bullestock/acsv2/mqtt-logger/README.md

This script subscribes to hal9k/acs/log/# and writes all received data to a log file.
The file is rotated hourly, and up to 30 files are kept.
