bullestock/acsv2/frontend/design/states.png

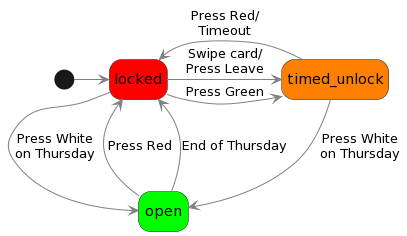
frontend/design/states.png
