bullestock/acsv2/frontend/case/bottom.step

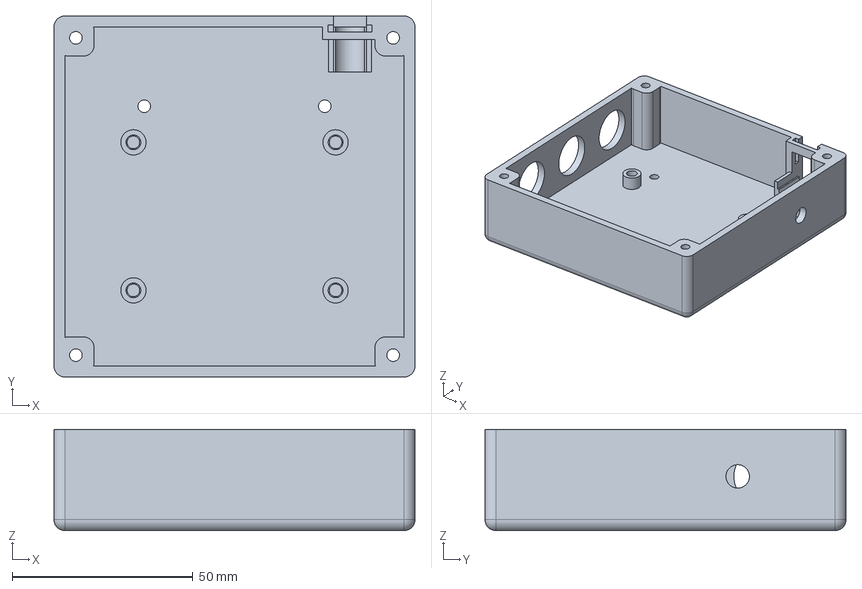
[picture p4: CAD file, 2026-07-11]
frontend/case/bottom.step
100.0 x 100.0 x 28.0 mm
