bullestock/acsv2/frontend/opi/installed-packages.txt

emacs-bin-common
emacs-common
emacs-nox
emacsen-common
libboost-iostreams1.74.0:armhf
libboost-program-options-dev:armhf
libboost-program-options1.74-dev:armhf
libboost-program-options1.74.0:armhf
libboost-regex1.74.0:armhf
libboost1.74-dev:armhf
libbpf0:armhf
libbrotli-dev:armhf
libbrotli1:armhf
libbsd0:armhf
libbz2-1.0:armhf
libc-bin
libc-dev-bin
libc6:armhf
libc6-dev:armhf
libcaca0:armhf
libcairo-gobject2:armhf
libcairo2:armhf
libcap-ng0:armhf
libcap2:armhf
libcap2-bin
libcc1-0:armhf
libcolord2:armhf
libcom-err2:armhf
libcpufreq0
libcrack2:armhf
libcrypt-dev:armhf
libcrypt1:armhf
libcryptsetup12:armhf
libctf-nobfd0:armhf
libctf0:armhf
libcups2:armhf
libcurl3-gnutls:armhf
libcurl4:armhf
libcurl4-openssl-dev:armhf
libcwidget4:armhf
libdaemon0:armhf
libdatrie1:armhf
libdb5.3:armhf
libdbus-1-3:armhf
libdconf1:armhf
libdebconfclient0:armhf
libdebuginfod1:armhf
libdeflate0:armhf
libdevmapper1.02.1:armhf
libdns-export1110
libdw1:armhf
libedit2:armhf
libelf1:armhf
libepoxy0:armhf
libestr0:armhf
libevent-2.1-7:armhf
libexpat1:armhf
libext2fs2:armhf
libfastjson4:armhf
libfdisk1:armhf
libfdt1:armhf
libffi-dev:armhf
libffi7:armhf
libfftw3-single3:armhf
libfido2-1:armhf
libfontconfig1:armhf
libfreetype6:armhf
libfribidi0:armhf
libfstrm0:armhf
libfuse2:armhf
libgcc-10-dev:armhf
libgcc-s1:armhf
libgcrypt20:armhf
libgcrypt20-dev
libgdbm-compat4:armhf
libgdbm6:armhf
libgdk-pixbuf-2.0-0:armhf
libgdk-pixbuf2.0-common
libgirepository-1.0-1:armhf
libglib2.0-0:armhf
libgmp-dev:armhf
libgmp10:armhf
libgmpxx4ldbl:armhf
libgnutls-dane0:armhf
libgnutls-openssl27:armhf
libgnutls28-dev:armhf
libgnutls30:armhf
libgnutlsxx28:armhf
libgomp1:armhf
libgpg-error-dev
libgpg-error0:armhf
libgpiod-dev:armhf
libgpiod2:armhf
libgpm2:armhf
libgraphite2-3:armhf
libgss-dev
libgss3:armhf
libgssapi-krb5-2:armhf
libgssrpc4:armhf
libgtk-3-0:armhf
libgtk-3-common
libgudev-1.0-0:armhf
libharfbuzz0b:armhf
libhavege2:armhf
libhogweed6:armhf
libi2c0:armhf
libidn2-0:armhf
libidn2-dev:armhf
libip4tc2:armhf
libip6tc2:armhf
libiperf0:armhf
libisc-export1105:armhf
libisl23:armhf
libiw30:armhf
libjansson4:armhf
libjbig0:armhf
libjq1:armhf
libjson-c5:armhf
libjson-glib-1.0-0:armhf
libjson-glib-1.0-common
libk5crypto3:armhf
libkadm5clnt-mit12:armhf
libkadm5srv-mit12:armhf
libkdb5-10:armhf
libkeyutils-dev:armhf
libkeyutils1:armhf
libklibc:armhf
libkmod2:armhf
libkrb5-3:armhf
libkrb5-dev:armhf
libkrb5support0:armhf
libksba8:armhf
liblcms2-2:armhf
liblmdb0:armhf
liblognorm5:armhf
liblz4-1:armhf
liblzma5:armhf
liblzo2-2:armhf
libmagic-mgc
libmagic1:armhf
libmaxminddb0:armhf
libmd0:armhf
libmm-glib0:armhf
libmnl0:armhf
libmount1:armhf
libmpc3:armhf
libmpdec3:armhf
libmpfr6:armhf
libncurses6:armhf
libncursesw6:armhf
libndp0:armhf
libnetfilter-conntrack3:armhf
libnettle8:armhf
libnewt0.52:armhf
libnfnetlink0:armhf
libnftnl11:armhf
libnghttp2-14:armhf
libnghttp2-dev
libnl-3-200:armhf
libnl-3-dev:armhf
libnl-genl-3-200:armhf
libnl-genl-3-dev:armhf
libnl-route-3-200:armhf
libnm0:armhf
libnpth0:armhf
libnsl-dev:armhf
libnsl2:armhf
libnss-myhostname:armhf
libnuma1:armhf
libonig5:armhf
libp11-kit-dev:armhf
libp11-kit0:armhf
libpackagekit-glib2-18:armhf
libpam-modules:armhf
libpam-modules-bin
libpam-runtime
libpam-systemd:armhf
libpam0g:armhf
libpango-1.0-0:armhf
libpangocairo-1.0-0:armhf
libpangoft2-1.0-0:armhf
libparted2:armhf
libpcap0.8:armhf
libpci3:armhf
libpcre2-8-0:armhf
libpcre3:armhf
libpcsclite1:armhf
libpipeline1:armhf
libpixman-1-0:armhf
libpkcs11-helper1:armhf
libpll-dev
libpll0
libpng16-16:armhf
libpolkit-agent-1-0:armhf
libpolkit-gobject-1-0:armhf
libpopt0:armhf
libprocps8:armhf
libprotobuf-c1:armhf
libproxy1v5:armhf
libpsl-dev:armhf
libpsl5:armhf
libqrencode4:armhf
libreadline8:armhf
librest-0.7-0:armhf
librhash0:armhf
librtmp-dev:armhf
librtmp1:armhf
libsamplerate0:armhf
libsasl2-2:armhf
libsasl2-dev
libsasl2-modules-db:armhf
libsctp1:armhf
libseccomp2:armhf
libselinux1:armhf
libsensors-config
libsensors5:armhf
libshishi-dev:armhf
libshishi0:armhf
libsigc++-2.0-0v5:armhf
libsigsegv2:armhf
libslang2:armhf
libslang2-modules:armhf
libsmartcols1:armhf
libsoup-gnome2.4-1:armhf
libsoup2.4-1:armhf
libsource-highlight-common
libsource-highlight4v5
libsqlite3-0:armhf
libss2:armhf
libssh2-1:armhf
libssh2-1-dev:armhf
libssl-dev:armhf
libstdc++-10-dev:armhf
libstdc++6:armhf
libsysfs2:armhf
libsystemd0:armhf
libtasn1-6:armhf
libtasn1-6-dev:armhf
libtcl8.6:armhf
libteamdctl0:armhf
libthai-data
libthai0:armhf
libtiff5:armhf
libtinfo6:armhf
libtirpc-common
libtirpc-dev:armhf
libtirpc3:armhf
libubsan1:armhf
libuchardet0:armhf
libudev1:armhf
libunbound8:armhf
libunistring-dev:armhf
libunistring2:armhf
libunwind8:armhf
libusb-1.0-0:armhf
libutempter0:armhf
libuuid1:armhf
libuv1:armhf
libvte-2.91-0:armhf
libvte-2.91-common
libwayland-client0:armhf
libwayland-cursor0:armhf
libwayland-egl1:armhf
libwrap0:armhf
libwrap0-dev:armhf
libx11-6:armhf
libx11-data
libxapian30:armhf
libxau6:armhf
libxcb-render0:armhf
libxcb-shm0:armhf
libxcb1:armhf
libxcomposite1:armhf
libxcursor1:armhf
libxdamage1:armhf
libxdmcp6:armhf
libxext6:armhf
libxfixes3:armhf
libxi6:armhf
libxinerama1:armhf
libxkbcommon0:armhf
libxml2:armhf
libxmuu1:armhf
libxrandr2:armhf
libxrender1:armhf
libxtables12:armhf
libxxhash0:armhf
libyaml-0-2:armhf
libz3-4:armhf
libz3-dev:armhf
libzstd1:armhf
zlib1g:armhf
zlib1g-dev:armhf
