bullestock/acsv2/reader/esp32/pcb/reader.kicad_pcb

## KiCad design reader/esp32/pcb/reader.kicad_pcb (2024-09-29)

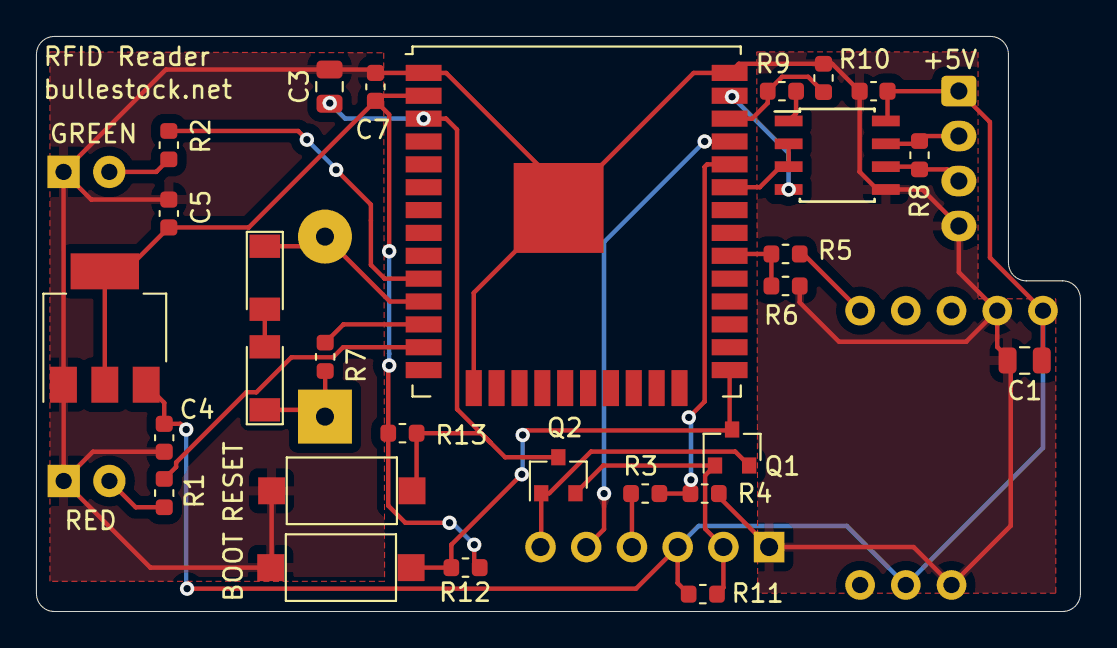
[picture p5: board reader.kicad_pcb from above]

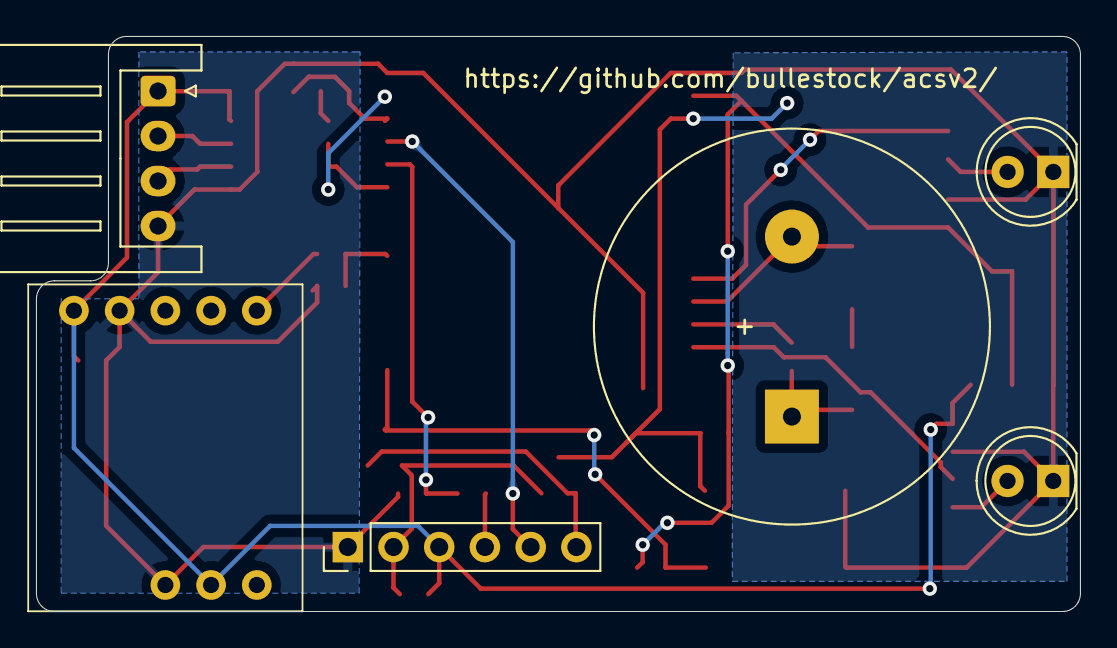
[picture p6: board reader.kicad_pcb from below]

Board: 11 copper layers, 58.0 x 31.9 mm, 34 parts (6 on the bottom side), 26 nets.

Parts:
BZ1: Buzzer; Buzzer_D22mm_H8mm_P10mm
C1, C3: 10u; C_0805_2012Metric
C2, C4, C5, C7: 100n; C_0603_1608Metric
D1, D2: LED; LED_D5.0mm
D3, D4: 3V9; D_MiniMELF
J1: Debug; PinHeader_1x06_P2.54mm_Vertical
J2: RS485; JST_XH_S04B-XH-A_1x04_P2.50mm_Horizontal
Q1, Q2: MMBT3904; SOT-23
R1, R2: 270; R_0603_1608Metric
R3, R5, R9: 1k2; R_0603_1608Metric
R4, R6, R10: 2k2; R_0603_1608Metric
R7: 100; R_0603_1608Metric
R8: 120; R_0603_1608Metric
R11: 4k7; R_0603_1608Metric
R12, R13: 10k; R_0603_1608Metric
SW1, SW2: SW_SPST; SW_SPST_CK_RS282G05A3
U1: ESP32-WROOM-32U
U2: RDM6300; RDM6300_B38.5x18.2mm
U3: MAX485E; SOIC-8_3.9x4.9mm_Pitch1.27mm
U5: AMS1117-3.3; SOT-223-3_TabPin2

Connections:
+3V3: C5.1, C7.1, R12.2, R13.1, U1.2 (VDD), U5.2 (VO)
+5V: C1.1, C2.1, C4.1, J1.3, J2.1, R11.1, U2.4 (5V), U2.10 (5V), U3.8 (VCC), U5.3 (VI)
BOOT: Q1.3 (C), R12.1, SW2.2 (B), U1.25 (IO0)
BUZ1: R7.1, U1.12 (IO27)
BUZ2: BZ1.2 (+), D4.1 (K), U1.11 (IO26)
DTR: J1.6, Q1.2 (E), Q2.1 (B)
ESP_RFID_TX: R5.2, R6.1, U1.30 (IO18)
ESP_RX: R3.2, R4.1, U1.34 (RXD0/IO3)
ESP_TX: J1.5, U1.35 (TXD0/IO1)
GND: C1.2, C2.2, C3.2, C4.2, C5.2, C7.2, D1.1 (K), D2.1 (K), J1.1, J2.4, R4.2, R6.2, R10.2, SW1.1 (A), SW2.1 (A), U1.1 (GND), U1.15 (GND), U1.38 (GND), U1.39 (GND), U2.3 (GND), U2.9 (GND), U3.5 (GND), U5.1 (GND)
GREEN: R2.2, U1.10 (IO25)
unnamed: BZ1.1 (-), D3.1 (K), R7.2
unnamed: D1.2 (A), R1.1
unnamed: D2.2 (A), R2.1
unnamed: D3.2 (A), D4.2 (A)
unnamed: J1.4, R3.1
unnamed: J2.2, R8.1, U3.7 (B)
unnamed: J2.3, R8.2, U3.6 (A)
unnamed: R5.1, U2.6 (TX)
unnamed: R9.1, U3.1 (RO)
RED: R1.2, U1.13 (IO14)
RESET: C3.1, Q2.3 (C), R13.2, SW1.2 (B), U1.3 (EN)
RTS: J1.2, Q1.1 (B), Q2.2 (E), R11.2
RTS485: U1.33 (IO21), U3.2 (~RE), U3.3 (DE)
RX485: R9.2, R10.1, U1.36 (IO22)
TX485: U1.37 (IO23), U3.4 (DI)
