bullestock/acsv2/frontend/pcb/frontend.kicad_pcb

## KiCad design frontend/pcb/frontend.kicad_pcb (2024-04-07)

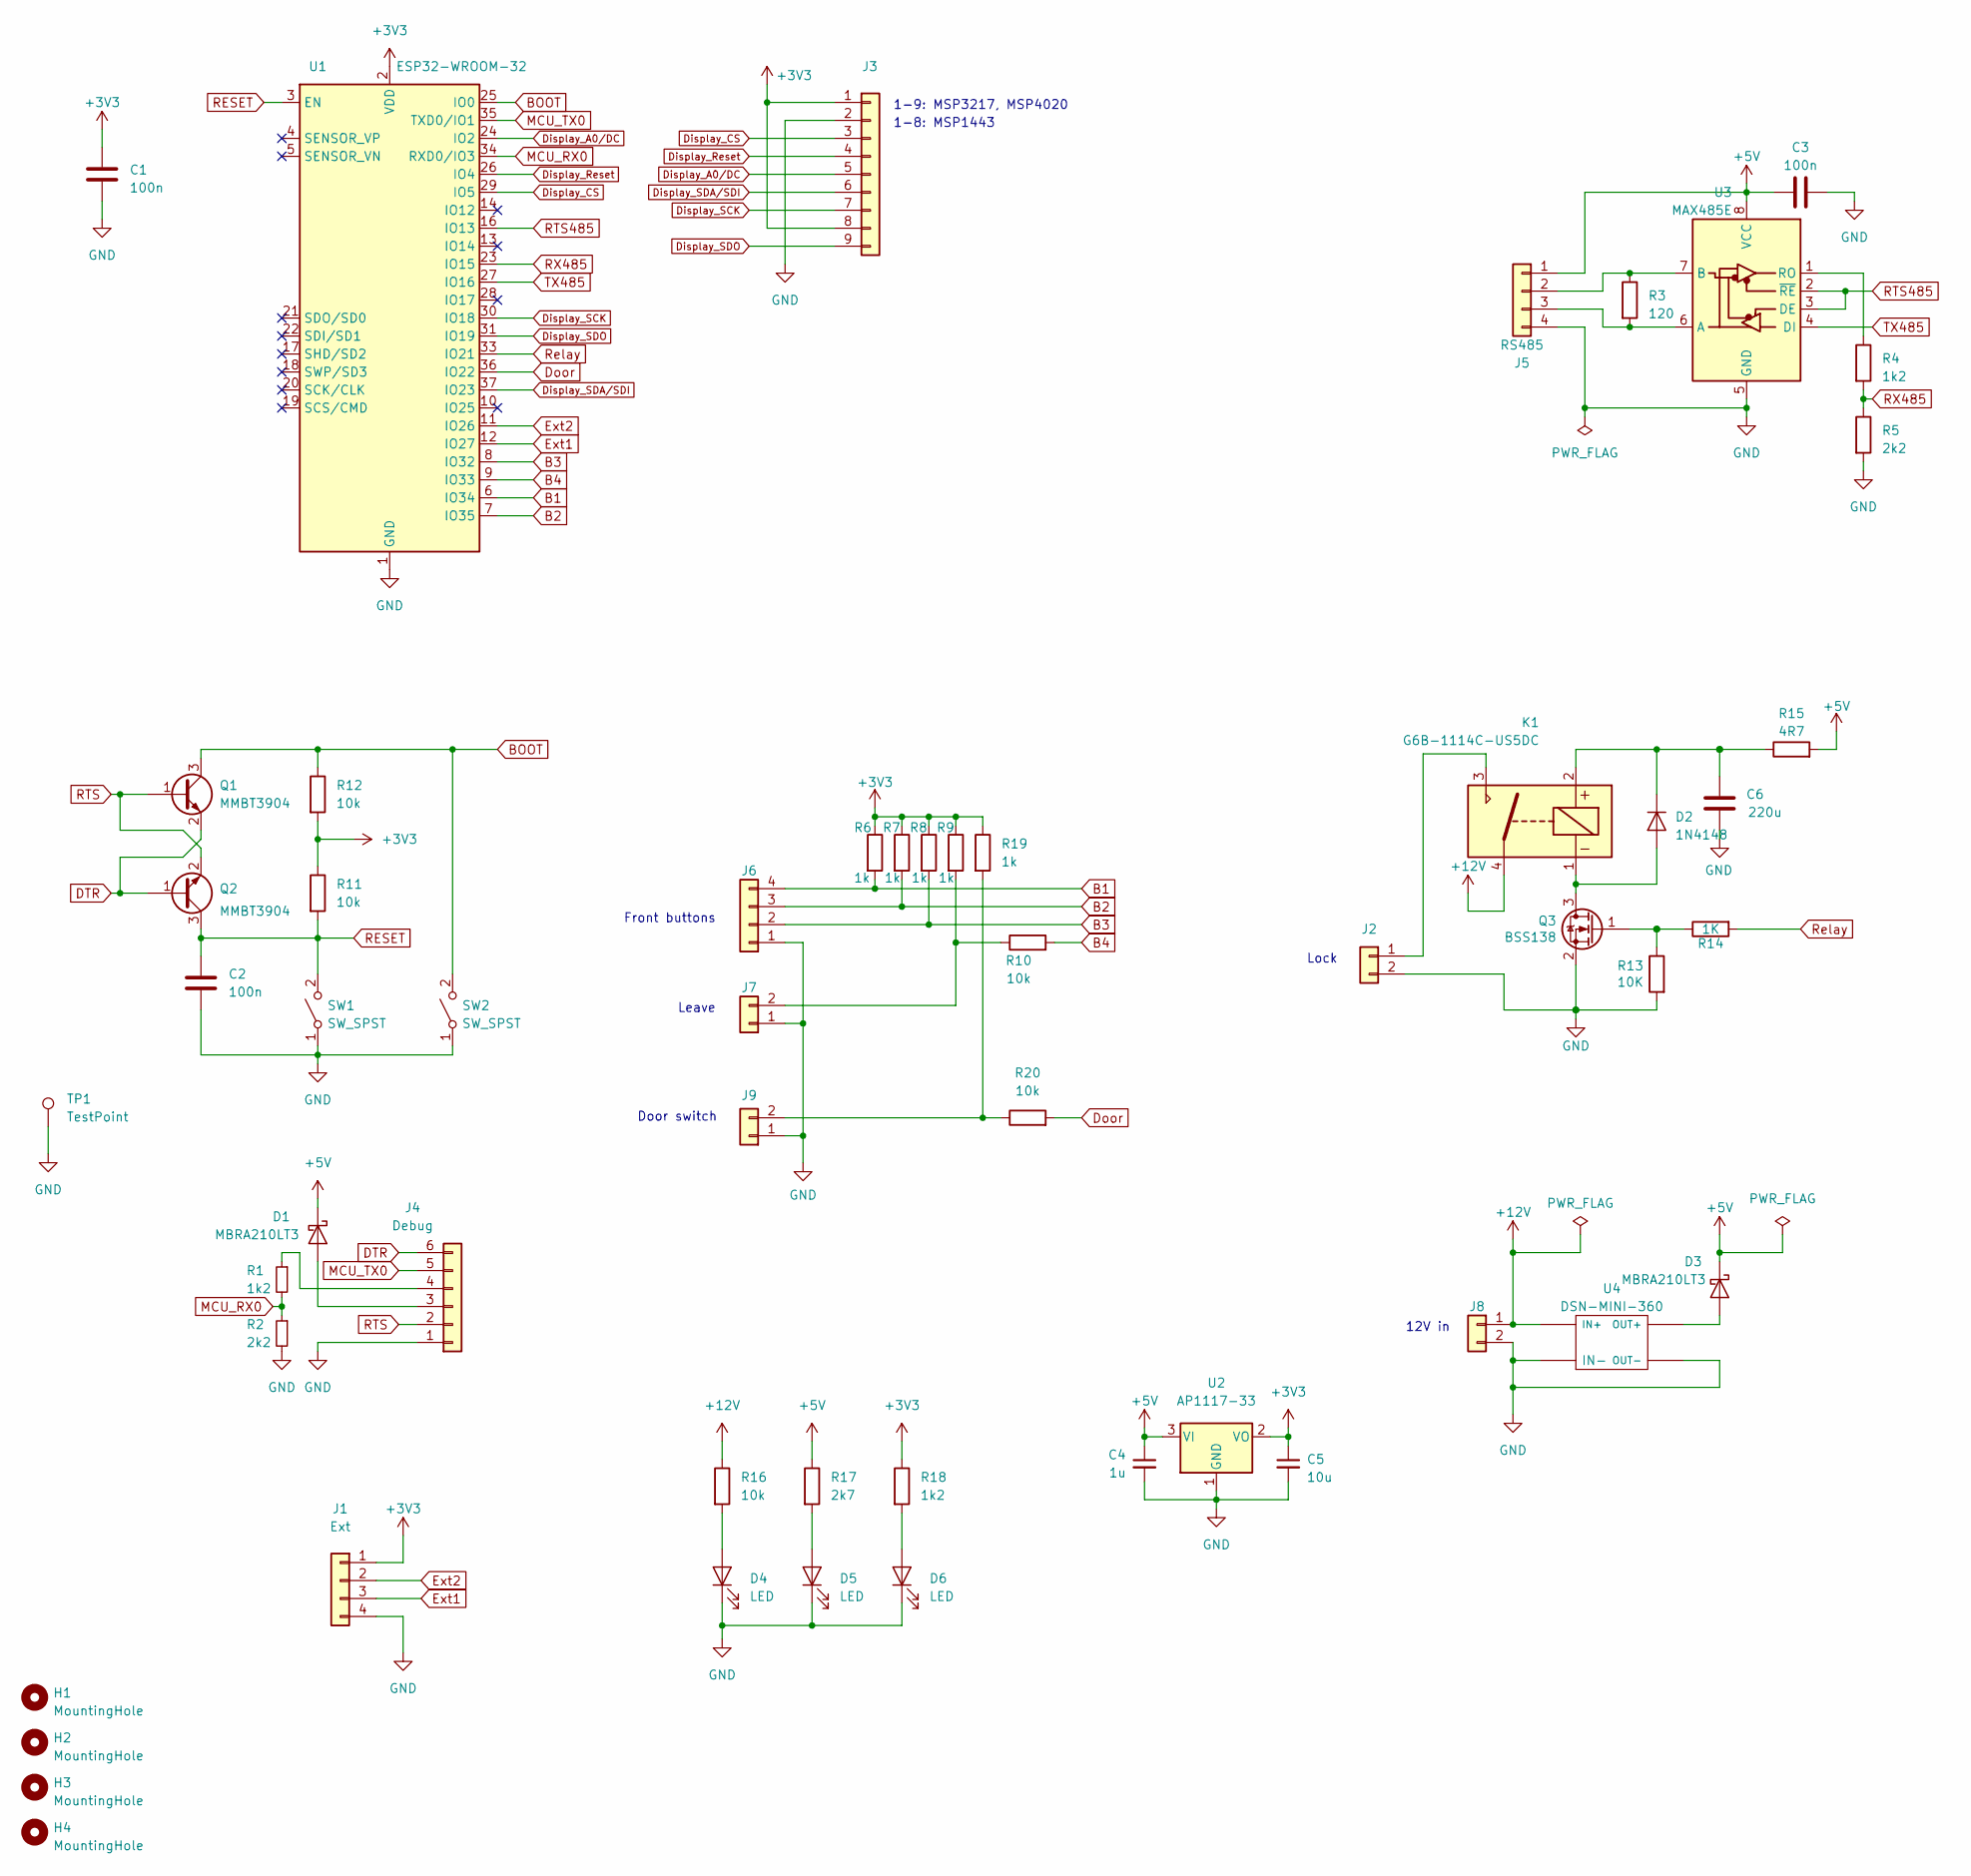
[picture p7: schematic frontend.kicad_sch]

Parts:
C1, C2, C3: 100n; C_0603_1608Metric
C4: 1u; C_0603_1608Metric
C5: 10u; C_0603_1608Metric
C6: 220u; CP_EIA-6032-28_Kemet-C
D1, D3: MBRA210LT3; D_SMA
D2: 1N4148; D_MiniMELF
D4, D5, D6: LED; LED_0603_1608Metric
H1, H2, H3, H4: MountingHole; MountingHole_3.2mm_M3
J1: Ext; PinHeader_1x04_P2.54mm_Vertical
J2: CONN_01X02; JST_XH_B2B-XH-A_1x02_P2.50mm_Vertical
J3: Display4020; PinHeader_1x09_P2.54mm_Vertical
J4: Debug; PinHeader_1x06_P2.54mm_Vertical
J5: RS485; JST_XH_B4B-XH-A_1x04_P2.50mm_Vertical
J6: Conn_01x04; JST_XH_B4B-XH-A_1x04_P2.50mm_Vertical
J7, J8, J9: Conn_01x02; JST_XH_B2B-XH-A_1x02_P2.50mm_Vertical
K1: G6B-1114C-US5DC; DIL-relay
Q1, Q2: MMBT3904; SOT-23
Q3: BSS138; SOT-23
R1, R4, R18: 1k2; R_0603_1608Metric
R2, R5: 2k2; R_0603_1608Metric
R3: 120; R_0603_1608Metric
R6, R7, R8, R9, R19: 1k; R_0603_1608Metric
R10, R11, R12, R16, R20: 10k; R_0603_1608Metric
R13: 10K; R_0603_1608Metric
R14: 1K; R_0603_1608Metric
R15: 4R7; R_0603_1608Metric
R17: 2k7; R_0603_1608Metric
SW1, SW2: SW_SPST; SW_SPST_CK_RS282G05A3
TP1: TestPoint; TestPoint_Keystone_5000-5004_Miniature
U1: ESP32-WROOM-32; ESP32-WROOM-32U
U2: AP1117-33; SOT-223-3_TabPin2
U3: MAX485E; SOIC-8_3.9x4.9mm_P1.27mm
U4: DSN-MINI-360

Connections:
+3V3: C1.1, C5.1, J1.1, J3.1, J3.8, R6.1, R7.1, R8.1, R9.1, R11.1, R12.2, R18.1, R19.1, U1.2 (VDD), U2.2 (VO)
+5V: C3.1, C4.1, D1.1 (K), D3.1 (K), J5.1, R15.2, R17.1, U2.3 (VI), U3.8 (VCC)
+12V: J8.1, K1.4, R16.1, U4.IN+
B1: J6.4, R6.2, U1.6 (IO34)
B2: J6.3, R7.2, U1.7 (IO35)
B3: J6.2, R8.2, U1.8 (IO32)
B4: R10.2, U1.9 (IO33)
BOOT: Q1.3 (C), R12.1, SW2.2 (B), U1.25 (IO0)
DTR: J4.6, Q1.2 (E), Q2.1 (B)
Display_A0/DC: J3.5, U1.24 (IO2)
Display_CS: J3.3, U1.29 (IO5)
Display_Reset: J3.4, U1.26 (IO4)
Display_SCK: J3.7, U1.30 (IO18)
Display_SDA/SDI: J3.6, U1.37 (IO23)
Display_SDO: J3.9, U1.31 (IO19)
Door: R20.2, U1.36 (IO22)
Ext1: J1.3, U1.12 (IO27)
Ext2: J1.2, U1.11 (IO26)
GND: C1.2, C2.2, C3.2, C4.2, C5.2, C6.2, D4.1 (K), D5.1 (K), D6.1 (K), J1.4, J2.2, J3.2, J4.1, J5.4, J6.1, J7.1, J8.2, J9.1, Q3.2 (S), R2.2, R5.2, R13.2, SW1.1 (A), SW2.1 (A), TP1.1, U1.1 (GND), U1.15 (GND), U1.38 (GND), U1.39 (GND), U2.1 (GND), U3.5 (GND), U4.IN-, U4.OUT-
MCU_RX0: R1.2, R2.1, U1.34 (RXD0/IO3)
MCU_TX0: J4.5, U1.35 (TXD0/IO1)
unnamed: D1.2 (A), J4.3
unnamed: D2.2 (A), K1.1, Q3.3 (D)
unnamed: C6.1, D2.1 (K), K1.2, R15.1
unnamed: D3.2 (A), U4.OUT+
unnamed: D4.2 (A), R16.2
unnamed: D5.2 (A), R17.2
unnamed: D6.2 (A), R18.2
unnamed: J2.1, K1.3
unnamed: J4.4, R1.1
unnamed: J5.2, R3.1, U3.7 (B)
unnamed: J5.3, R3.2, U3.6 (A)
unnamed: J7.2, R9.2, R10.1
unnamed: J9.2, R19.2, R20.1
unnamed: Q3.1 (G), R13.1, R14.1
unnamed: R4.1, U3.1 (RO)
RESET: C2.1, Q2.3 (C), R11.2, SW1.2 (B), U1.3 (EN)
RTS: J4.2, Q1.1 (B), Q2.2 (E)
RTS485: U1.16 (IO13), U3.2 (~RE), U3.3 (DE)
RX485: R4.2, R5.1, U1.23 (IO15)
Relay: R14.2, U1.33 (IO21)
TX485: U1.27 (IO16), U3.4 (DI)

Notes on the sheet:
Door switch
1-8: MSP1443
Lock
12V in
1-9: MSP3217, MSP4020
Front buttons
Leave

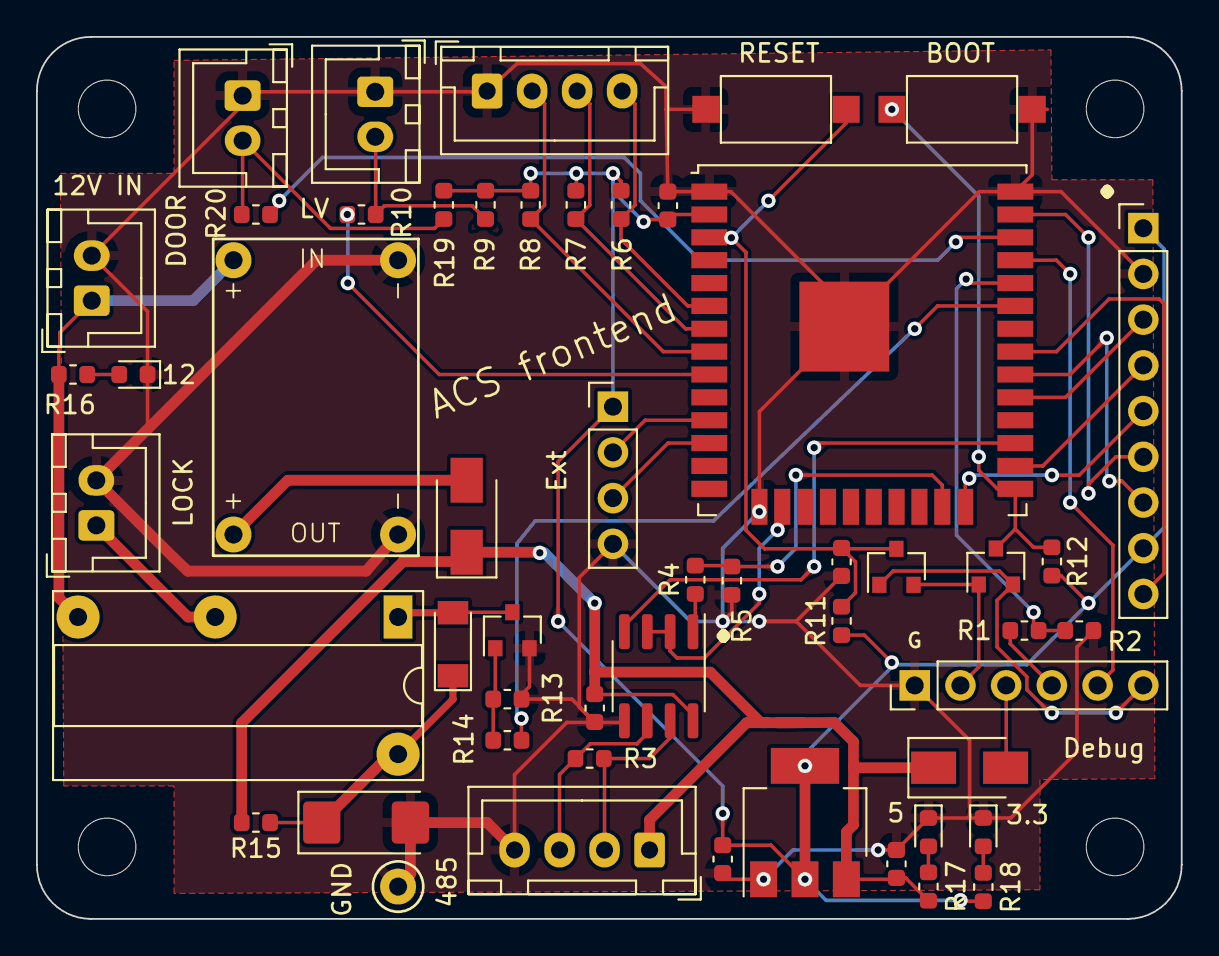
[picture p8: board frontend.kicad_pcb from above]

Board: 2 copper layers, 63.6 x 49.0 mm, 56 parts (0 on the bottom side), 42 nets.
