bullestock/acsv2/barn/pcb/hat/hat.kicad_pcb

## KiCad design barn/pcb/hat/hat.kicad_pcb (2023-07-16)

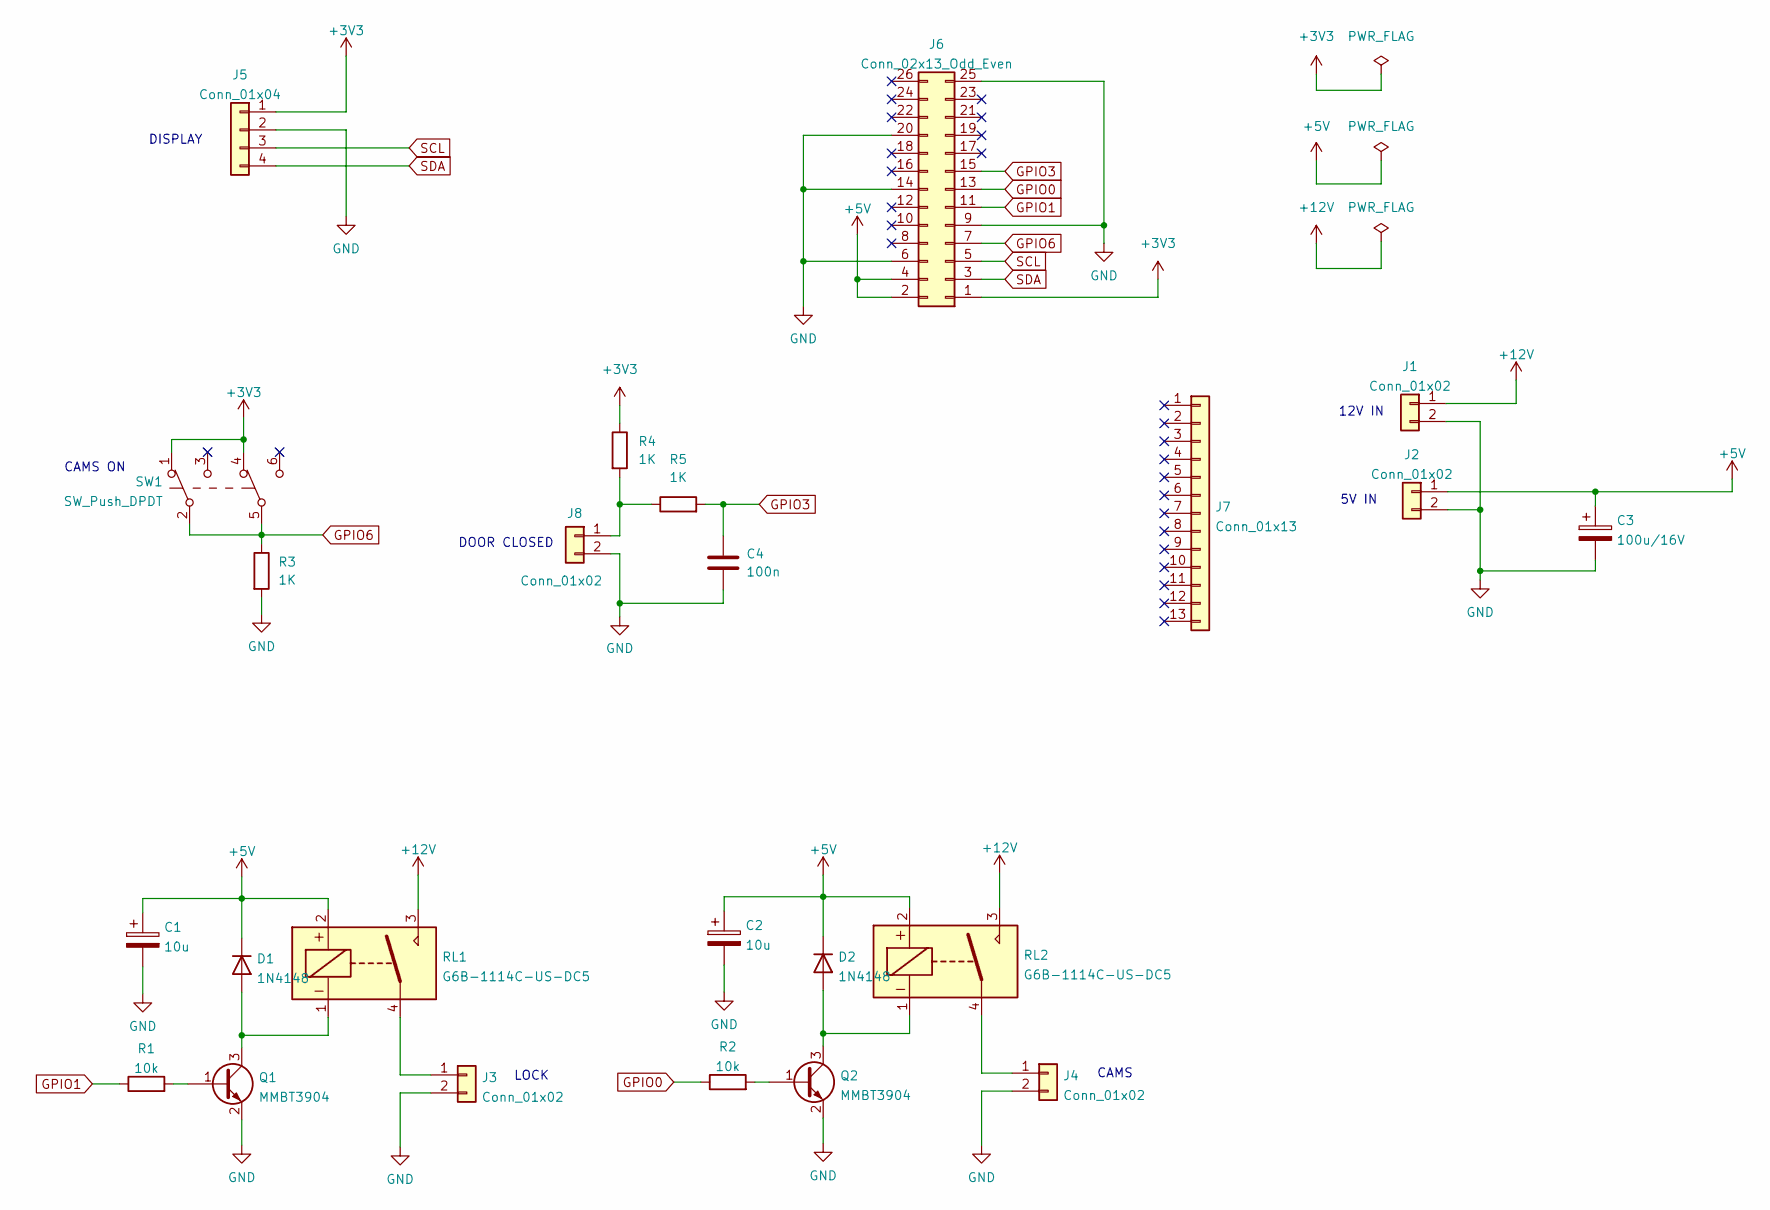
[picture p9: schematic hat.kicad_sch]

Parts:
C1, C2: 10u; CP_EIA-6032-28_Kemet-C
C3: 100u/16V; CP_EIA-7343-43_Kemet-X
C4: 100n; C_0603_1608Metric
D1, D2: 1N4148; D_MiniMELF
J1, J2, J3, J4, J8: Conn_01x02; JST_XH_B2B-XH-A_1x02_P2.50mm_Vertical
J5: Conn_01x04; PinSocket_1x04_P2.54mm_Vertical
J6: Conn_02x13_Odd_Even; PinSocket_2x13_P2.54mm_Vertical
J7: Conn_01x13; PinSocket_1x13_P2.54mm_Vertical
Q1, Q2: MMBT3904; SOT-23
R1, R2: 10k; R_0603_1608Metric
R3, R4, R5: 1K; R_0603_1608Metric
RL1, RL2: G6B-1114C-US-DC5; DIL-relay
SW1: SW_Push_DPDT; SW_PUSH_8.5x8.5_DPDT

Connections:
+3V3: J5.1, J6.1, R4.1, SW1.1 (A), SW1.4 (A)
+5V: C1.1, C2.1, C3.1, D1.1 (K), D2.1 (K), J2.1, J6.2, J6.4, RL1.2, RL2.2
+12V: J1.1, RL1.3, RL2.3
GND: C1.2, C2.2, C3.2, C4.2, J1.2, J2.2, J3.2, J4.2, J5.2, J6.6, J6.9, J6.14, J6.20, J6.25, J8.2, Q1.2 (E), Q2.2 (E), R3.2
GPIO0: J6.13, R2.1
GPIO1: J6.11, R1.1
GPIO3: C4.1, J6.15, R5.2
GPIO6: J6.7, R3.1, SW1.2 (B), SW1.5 (B)
unnamed: D1.2 (A), Q1.3 (C), RL1.1
unnamed: D2.2 (A), Q2.3 (C), RL2.1
unnamed: J3.1, RL1.4
unnamed: J4.1, RL2.4
unnamed: J8.1, R4.2, R5.1
unnamed: Q1.1 (B), R1.2
unnamed: Q2.1 (B), R2.2
SCL: J5.3, J6.5
SDA: J5.4, J6.3

Notes on the sheet:
CAMS ON
DOOR CLOSED
LOCK
DISPLAY
5V IN
CAMS
12V IN

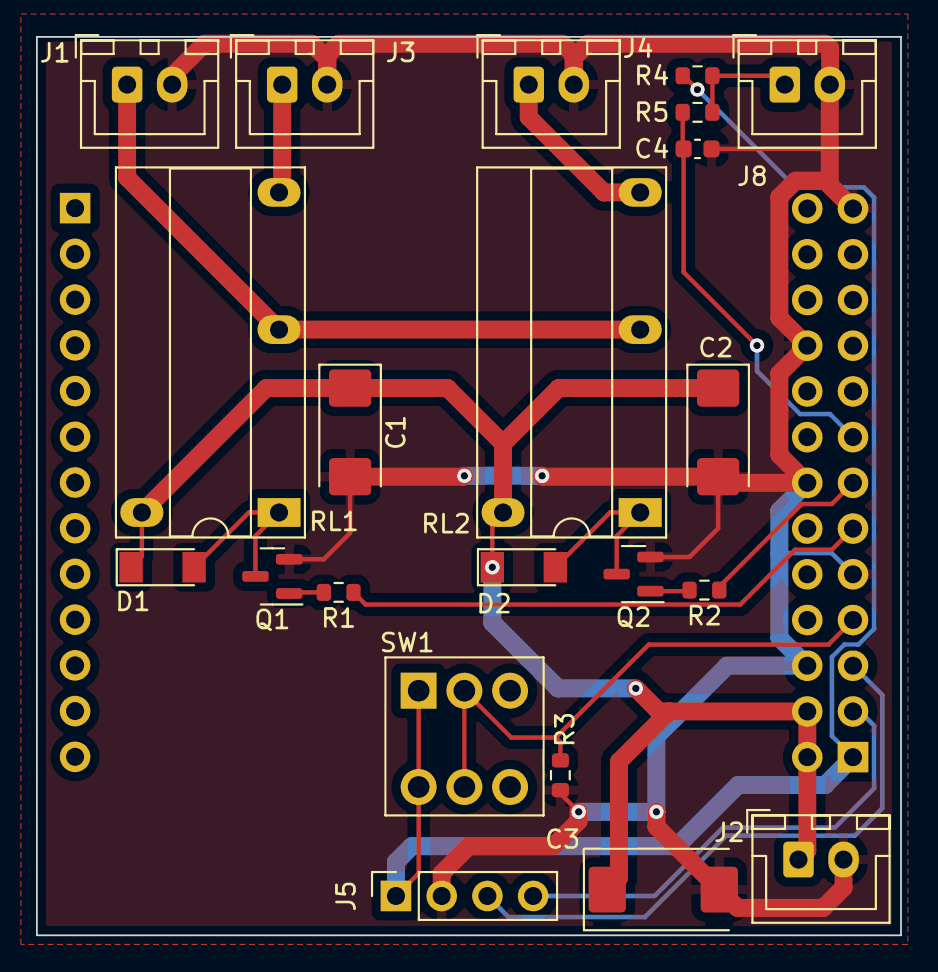
[picture p10: board hat.kicad_pcb from above]

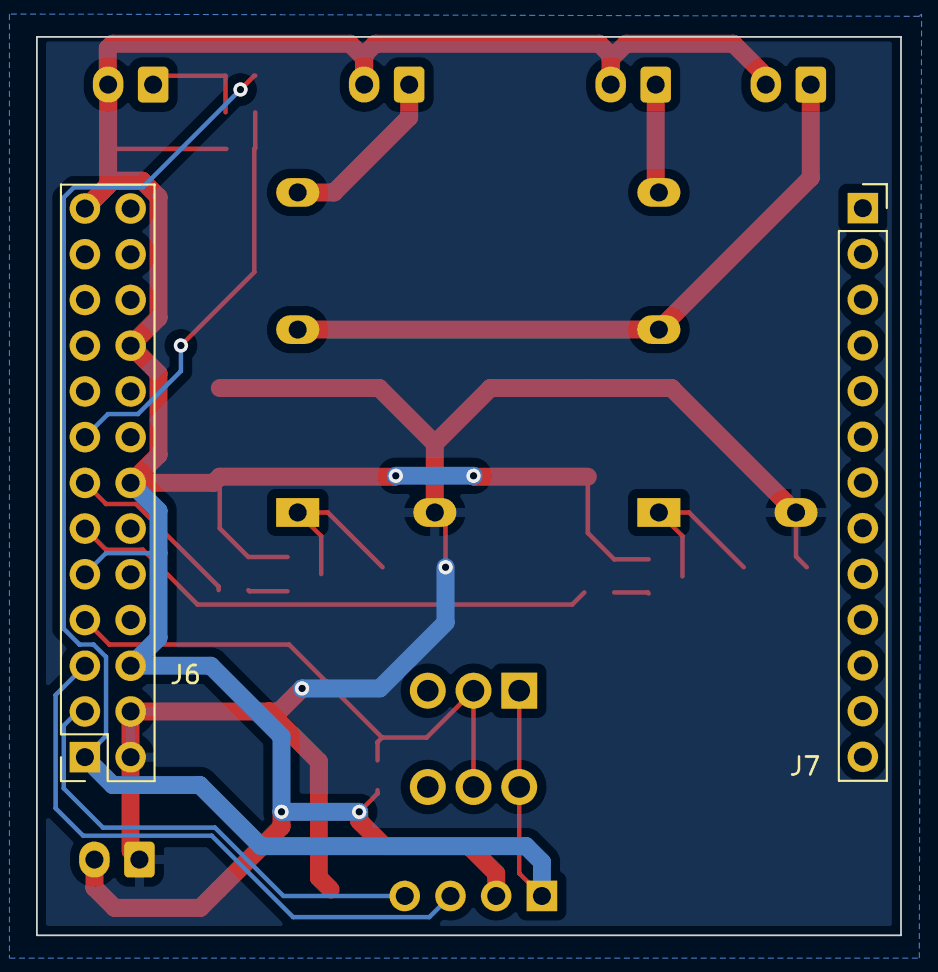
[picture p11: board hat.kicad_pcb from below]

Board: 2 copper layers, 48.0 x 49.9 mm, 24 parts (2 on the bottom side), 17 nets.
