bullestock/acsv2/frontend/hw/display/display.kicad_pcb

## KiCad design frontend/hw/display/display.kicad_pcb (2022-04-20)

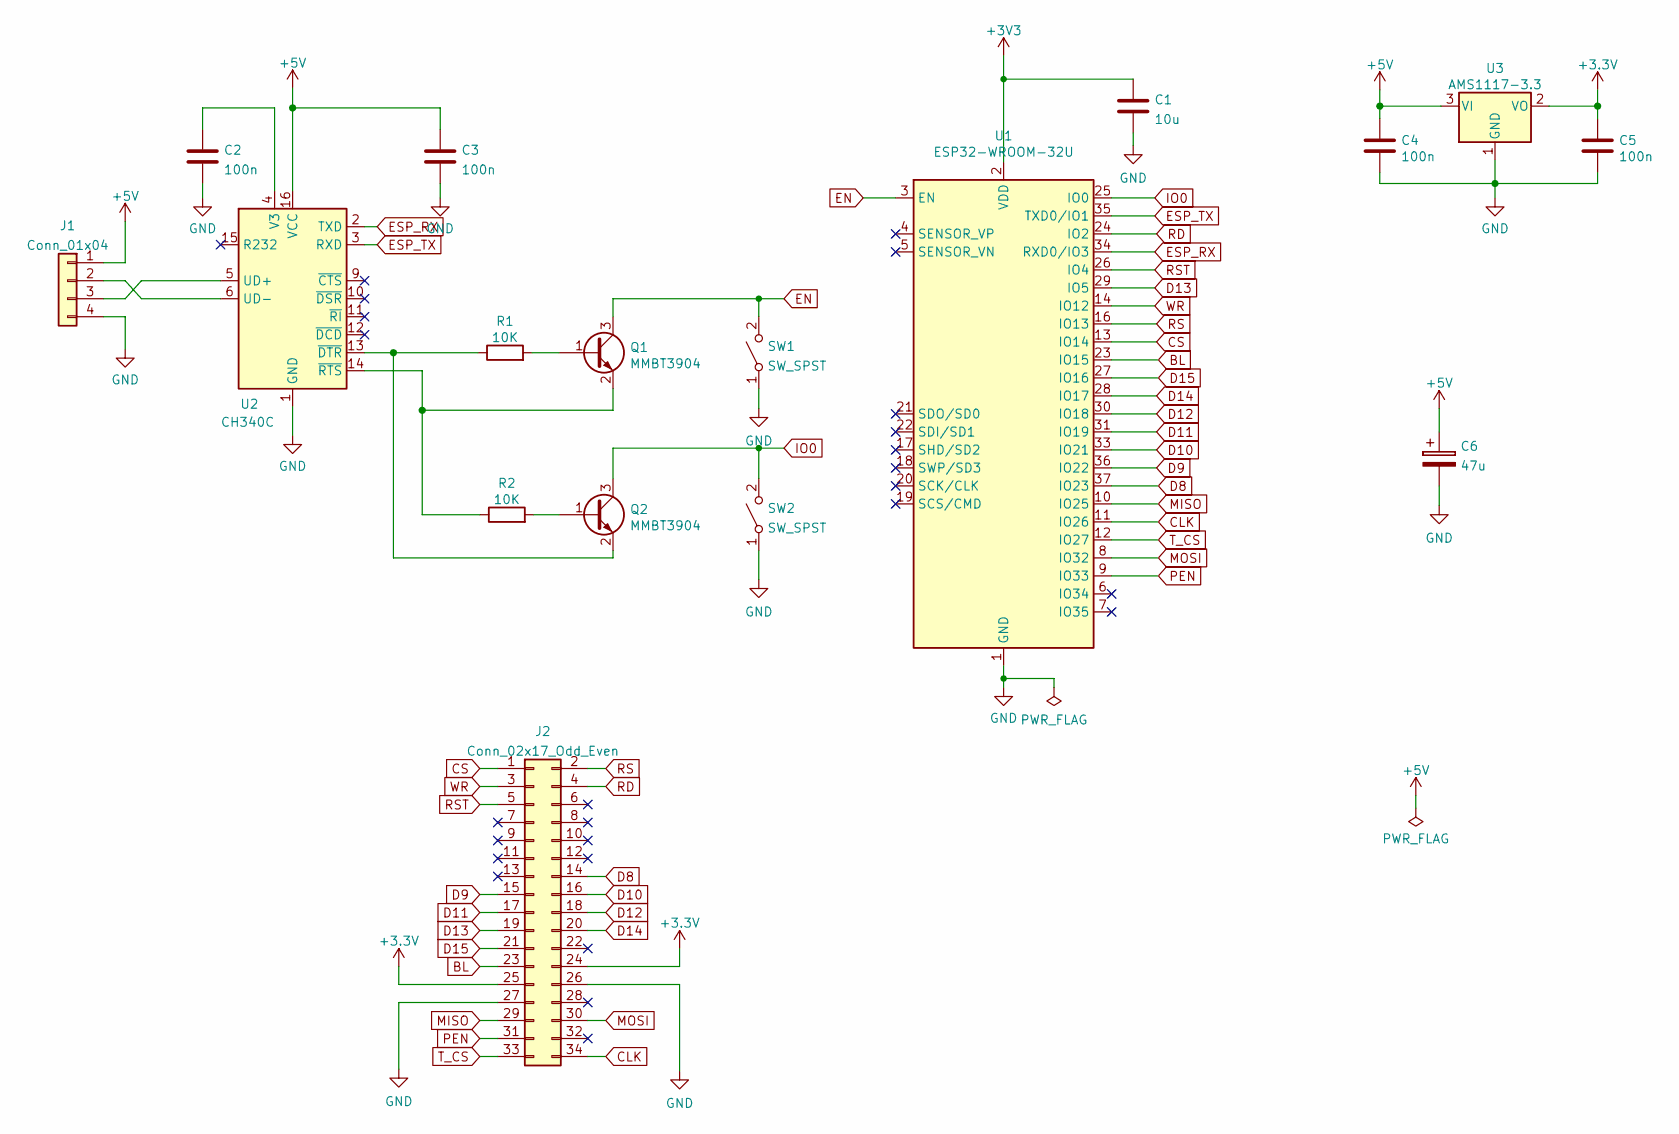
[picture p12: schematic display.kicad_sch]

Parts:
C1: 10u; C_0805_2012Metric
C2, C3, C4, C5: 100n; C_0603_1608Metric
C6: 47u; CP_EIA-7343-43_Kemet-X
J1: Conn_01x04; JST_XH_B4B-XH-A_1x04_P2.50mm_Vertical
J2: Conn_02x17_Odd_Even; PinHeader_2x17_P2.54mm_Vertical
Q1, Q2: MMBT3904; SOT-23
R1, R2: 10K; R_0603_1608Metric
SW1, SW2: SW_SPST; SW_SPST_CK_RS282G05A3
U1: ESP32-WROOM-32U; ESP32-WROOM-32
U2: CH340C; SOIC-16_3.9x9.9mm_P1.27mm
U3: AMS1117-3.3; SOT-223-3_TabPin2

Connections:
+5V: C3.1, C4.1, C6.1, J1.1, U2.16 (VCC), U3.3 (VI)
BL: J2.23, U1.23 (IO15)
CLK: J2.34, U1.11 (IO26)
CS: J2.1, U1.13 (IO14)
D8: J2.14, U1.37 (IO23)
D9: J2.15, U1.36 (IO22)
D10: J2.16, U1.33 (IO21)
D11: J2.17, U1.31 (IO19)
D12: J2.18, U1.30 (IO18)
D13: J2.19, U1.29 (IO5)
D14: J2.20, U1.28 (IO17)
D15: J2.21, U1.27 (IO16)
EN: Q1.3 (C), SW1.2 (B), U1.3 (EN)
ESP_RX: U1.34 (RXD0/IO3), U2.2 (TXD)
ESP_TX: U1.35 (TXD0/IO1), U2.3 (RXD)
GND: C1.2, C2.2, C3.2, C4.2, C5.2, C6.2, J1.4, J2.26, J2.27, SW1.1 (A), SW2.1 (A), U1.1 (GND), U1.15 (GND), U1.38 (GND), U1.39 (GND), U2.1 (GND), U3.1 (GND)
IO0: Q2.3 (C), SW2.2 (B), U1.25 (IO0)
MISO: J2.29, U1.10 (IO25)
MOSI: J2.30, U1.8 (IO32)
unnamed: C2.1, U2.4 (V3)
unnamed: J1.2, U2.6 (UD-)
unnamed: J1.3, U2.5 (UD+)
unnamed: Q1.1 (B), R1.2
unnamed: Q1.2 (E), R2.1, U2.14 (~RTS)
unnamed: Q2.1 (B), R2.2
unnamed: Q2.2 (E), R1.1, U2.13 (~DTR)
PEN: J2.31, U1.9 (IO33)
RD: J2.4, U1.24 (IO2)
RS: J2.2, U1.16 (IO13)
RST: J2.5, U1.26 (IO4)
T_CS: J2.33, U1.12 (IO27)
WR: J2.3, U1.14 (IO12)

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
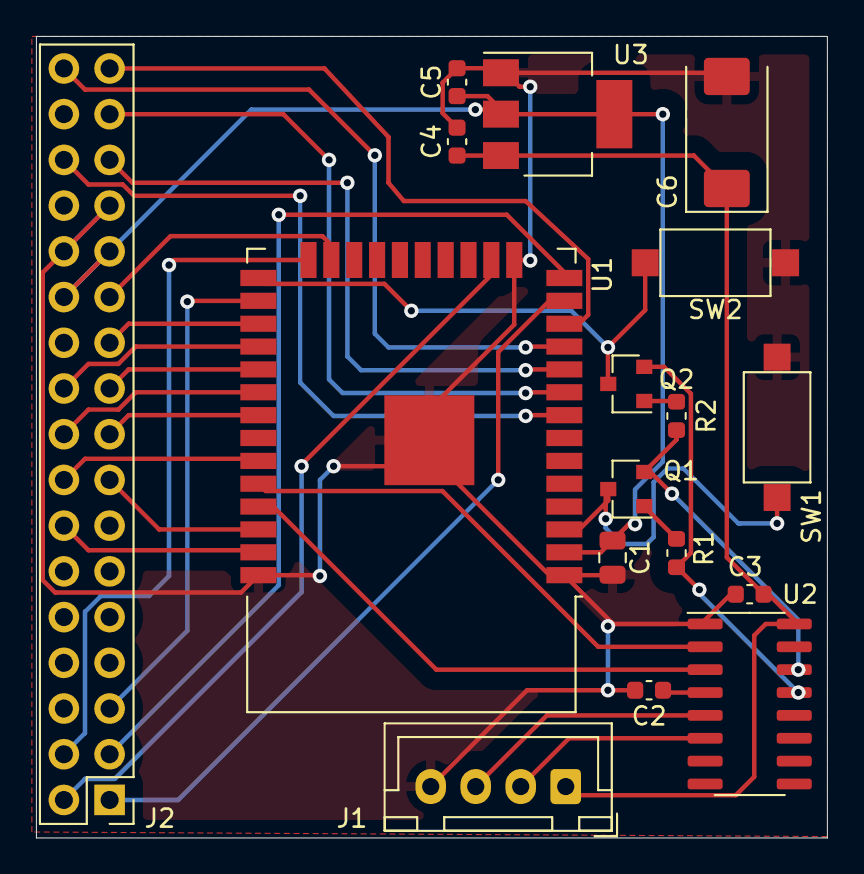
[picture p13: board display.kicad_pcb from above]

Board: 2 copper layers, 43.9 x 44.5 mm, 17 parts (0 on the bottom side), 33 nets.
