bullestock/acsv2/frontend/hw/interface/interface.kicad_pcb

## KiCad design frontend/hw/interface/interface.kicad_pcb (2022-02-18)

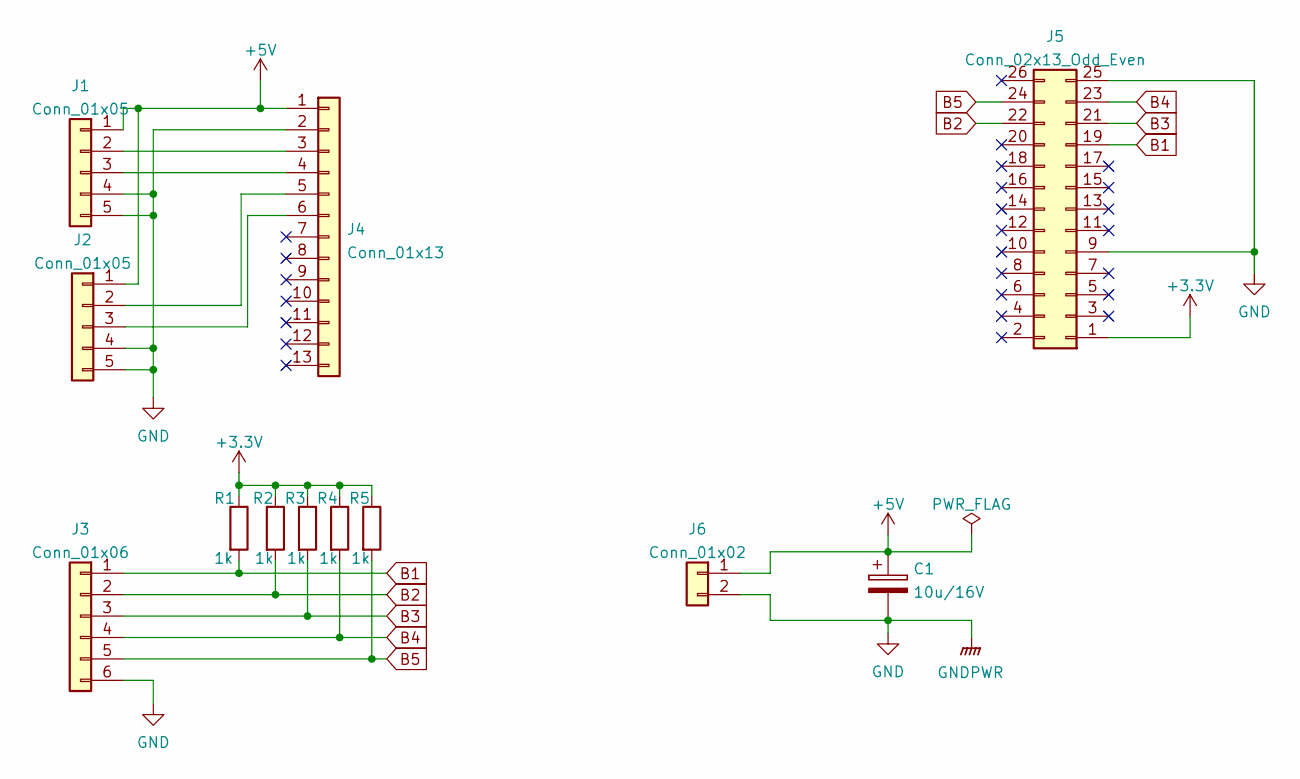
[picture p14: schematic interface.kicad_sch]

Parts:
C1: 10u/16V; CP_EIA-7343-43_Kemet-X
J1, J2: Conn_01x05; USB_A_Molex_67643_Horizontal
J3: Conn_01x06; JST_XH_S6B-XH-A_1x06_P2.50mm_Horizontal
J4: Conn_01x13; PinSocket_1x13_P2.54mm_Vertical
J5: Conn_02x13_Odd_Even; PinSocket_2x13_P2.54mm_Vertical
J6: Conn_01x02; JST_XH_S2B-XH-A_1x02_P2.50mm_Horizontal
R1, R2, R3, R4, R5: 1k; R_0603_1608Metric

Connections:
+3V3: J5.1, R1.1, R2.1, R3.1, R4.1, R5.1
+5V: C1.1, J1.1, J2.1, J4.1, J6.1
B1: J3.1, J5.19, R1.2
B2: J3.2, J5.22, R2.2
B3: J3.3, J5.21, R3.2
B4: J3.4, J5.23, R4.2
B5: J3.5, J5.24, R5.2
GND: C1.2, J1.4, J1.5, J2.4, J2.5, J3.6, J4.2, J5.9, J5.25, J6.2
unnamed: J1.2, J4.3
unnamed: J1.3, J4.4
unnamed: J2.2, J4.5
unnamed: J2.3, J4.6

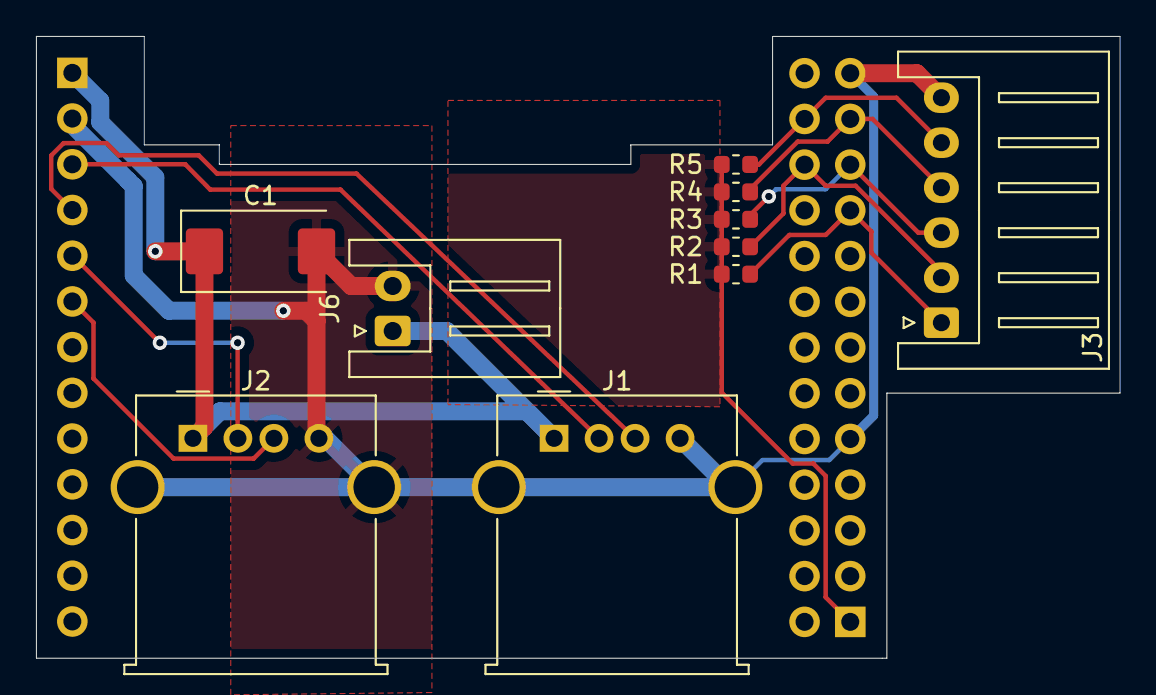
[picture p15: board interface.kicad_pcb from above]

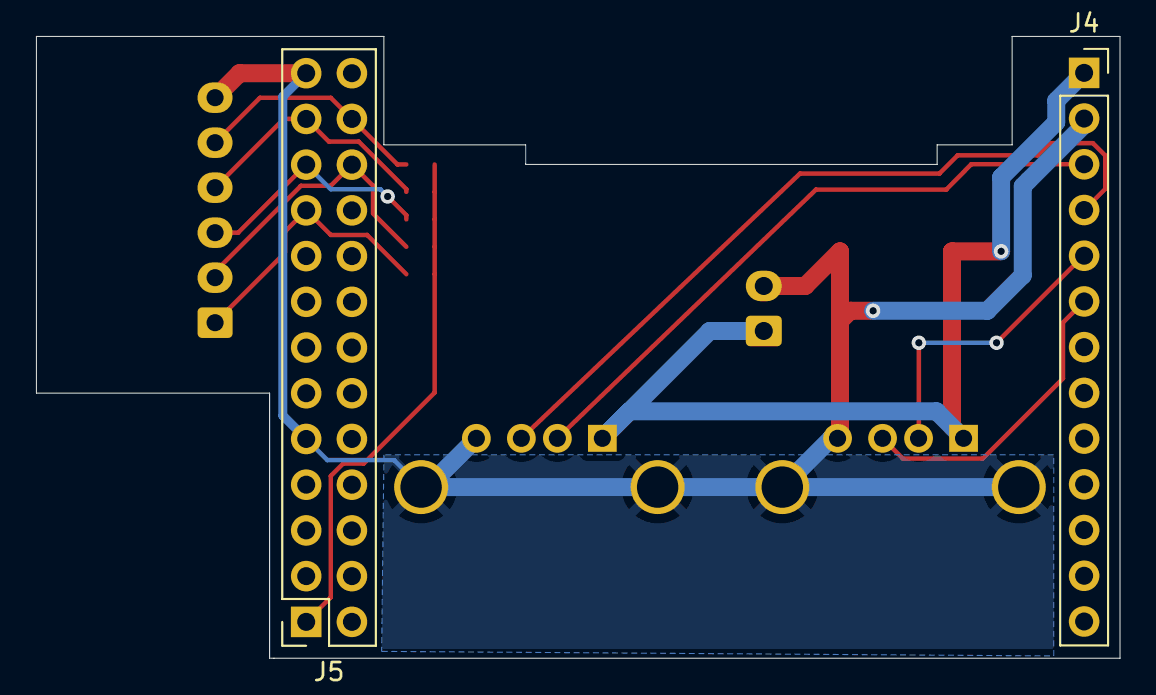
[picture p16: board interface.kicad_pcb from below]

Board: 2 copper layers, 60.2 x 34.5 mm, 12 parts (2 on the bottom side), 12 nets.
