bullestock/acsv2/frontend/esp32/main/main.cpp

#include <stdio.h>
#include <string>
#include <vector>

#include <freertos/FreeRTOS.h>
#include <freertos/task.h>
#include "esp_app_desc.h"
#include "esp_wifi.h"

#include "cardreader.h"
#include "connect.h"
#include "console.h"
#include "controller.h"
#include "defs.h"
#include "display.h"
#include "format.h"
#include "hw.h"
#include "mqtt.h"
#include "nvs.h"
#include "otafwu.h"
#include "rs485.h"
#include "sntp.h"

static constexpr const char* TAG = "main";

using Thresholds = std::vector<std::pair<float, uint16_t>>;

void fatal_error(Display& display, const std::string& error)
{
    printf("FATAL: %s\n", error.c_str());
    const auto msg = "ERROR:\n" + error;
    display.set_status(msg, TFT_RED);
    set_relay(false);
    
    while (1)
        vTaskDelay(10/portTICK_PERIOD_MS);
}

extern "C"
void app_main()
{
    init_hardware();
    init_rs485();

    const auto app_desc = esp_app_get_description();
                                                  
    printf("ACS frontend v %s\n", app_desc->version);

    TFT_eSPI tft;
    Display display(tft);
    display.add_progress(format("ACS v %s", app_desc->version));

    display.add_progress("NVS init");

    init_nvs();

    display.add_progress(format("ID %s", get_identifier().c_str()));
    ESP_LOGI(TAG, "Ident %s", get_identifier().c_str());

    const auto buttons = Buttons::read();
    if (buttons.red && buttons.green)
    {
        ESP_LOGI(TAG, "Entering console");
        display.add_progress("Entering console");
        run_console(display);        // never returns
    }

    bool connected = false;
    const auto wifi_creds = get_wifi_creds();
    if (!wifi_creds.empty())
    {
        ESP_ERROR_CHECK(esp_netif_init());
        ESP_ERROR_CHECK(esp_event_loop_create_default());

        display.add_progress("Connect to WiFi");

        int attempts_left = 3;
        while (!connected && attempts_left)
        {
            connected = connect(wifi_creds);
            ESP_LOGI(TAG, "Connected: %d attempts: %d",
                     connected, attempts_left);
            if (!connected)
            {
                disconnect();
                vTaskDelay(10000 / portTICK_PERIOD_MS);
                --attempts_left;
            }
        }
    }
    display.add_progress("Wait for console");

    printf("\n\nPress a key to enter console\n");
    bool debug = false;
    for (int i = 0; i < 20; ++i)
    {
        if (getchar() != EOF)
        {
            debug = true;
            break;
        }
        vTaskDelay(100/portTICK_PERIOD_MS);
    }
    if (connected)
    {
        ESP_LOGI(TAG, "Connected to WiFi");
        ESP_ERROR_CHECK(esp_wifi_set_ps(WIFI_PS_NONE));

        display.add_progress("SNTP synch");

        initialize_sntp();
            
        display.add_progress("Connected");

        Card_cache::instance().set_api_token(get_acs_token());
        xTaskCreate(card_cache_task, "cache_task", 4*1024, NULL, 1, NULL);
        Mqtt::instance().start(get_mqtt_address());
    }
    
    xTaskCreate(card_reader_task, "cr_task", 4*1024, NULL, 1, NULL);
    
    if (debug)
        run_console(display);        // never returns

    Mqtt::instance().write_slack(format(":frontend: ACS frontend %s", app_desc->version));

    printf("\nStarting application\n");
    display.start_uptime_counter();
    bool do_ota_check = gpio_get_level(PIN_EXT_1);
    if (!do_ota_check)
    {
        display.add_progress("OTA disabled");
        printf("OTA firmware update disabled by EXT1\n");
    }
    else if (connected)
    {
        display.add_progress("OTA check");
        if (!check_ota_update(display))
            display.add_progress("FAILED!");
    }
    esp_log_level_set("esp_wifi", ESP_LOG_ERROR);
    esp_log_level_set("wifi", ESP_LOG_ERROR);
    //esp_log_level_set("HTTP_CLIENT", ESP_LOG_DEBUG);
    display.add_progress("Starting");
    Mqtt::instance().log(format("ACS frontend %s", app_desc->version));

    Controller controller(display, Card_reader::instance());
    display.clear();
    controller.run(); // never returns
}

// Local Variables:
// compile-command: "cd .. && idf.py build"
// End:
