bullestock/acsv2/reader/esp32/src/main/console.cpp

#include "buzzer.h"
#include "console.h"
#include "defines.h"
#include "led.h"
#include "rs485.h"

#include <cmath>
#include <stdio.h>
#include <string.h>
#include <string>
#include <utility>

#include <esp_system.h>
#include <esp_log.h>
#include <esp_console.h>
#include <esp_vfs_dev.h>
#include <freertos/FreeRTOS.h>
#include <freertos/task.h>
#include <driver/uart.h>
#include <linenoise/linenoise.h>
#include <argtable3/argtable3.h>
#include <nvs.h>
#include <nvs_flash.h>

bool get_int(const std::string& line, int& index, int& value)
{
    while (index < line.size() && line[index] == ' ')
        ++index;
    if (!isdigit(line[index]))
    {
        printf("Expected number, got %d at %d\n", int(line[index]), index);
        return false;
    }
    value = 0;
    while (index < line.size() && isdigit(line[index]))
    {
        value = value*10 + line[index] - '0';
        ++index;
    }
    return true;
}

static std::string version()
{
    return "ACS ESP32 cardreader v " VERSION "\n";
}

static std::string get_card()
{
    const auto id = get_and_clear_last_cardid();
    if (!id)
        return "ID\n";
    char buf[20];
    sprintf(buf, "ID%10llX\n", id);
    return buf;
}

// S1000 100
static bool play_sound(const std::string line)
{
    int start = 0;
    int frequency = 0;
    int duration = 0;
    if (!get_int(line, start, frequency) ||
        !get_int(line, start, duration))
        return false;
    beep(frequency, duration);
    return true;
}

static bool set_led_intensity(const std::string line)
{
    extern int pwm_max;

    int intensity = 0;
    int start = 0;
    if (!get_int(line, start, intensity) || intensity > 100)
        return false;
    pwm_max = static_cast<int>(intensity/100.0*1023);

    return true;
}

void initialize_console()
{
    setvbuf(stdin, NULL, _IONBF, 0);

    /* Minicom, screen, idf_monitor send CR when ENTER key is pressed */
    esp_vfs_dev_uart_port_set_rx_line_endings(0, ESP_LINE_ENDINGS_CR);
    /* Move the caret to the beginning of the next line on '\n' */
    esp_vfs_dev_uart_port_set_tx_line_endings(0, ESP_LINE_ENDINGS_CRLF);

    /* Configure UART. Note that REF_TICK is used so that the baud rate remains
     * correct while APB frequency is changing in light sleep mode.
     */
    uart_config_t uart_config;
    memset(&uart_config, 0, sizeof(uart_config));
    uart_config.baud_rate = CONFIG_ESP_CONSOLE_UART_BAUDRATE;
    uart_config.data_bits = UART_DATA_8_BITS;
    uart_config.parity = UART_PARITY_DISABLE;
    uart_config.stop_bits = UART_STOP_BITS_1;
    uart_config.source_clk = UART_SCLK_REF_TICK;
    ESP_ERROR_CHECK(uart_param_config((uart_port_t) CONFIG_ESP_CONSOLE_UART_NUM, &uart_config));

    /* Install UART driver for interrupt-driven reads and writes */
    ESP_ERROR_CHECK(uart_driver_install((uart_port_t) CONFIG_ESP_CONSOLE_UART_NUM,
                                         256, 0, 0, NULL, 0));

    /* Tell VFS to use UART driver */
    esp_vfs_dev_uart_use_driver(CONFIG_ESP_CONSOLE_UART_NUM);

    /* Initialize the console */
    esp_console_config_t console_config;
    memset(&console_config, 0, sizeof(console_config));
    console_config.max_cmdline_args = 8;
    console_config.max_cmdline_length = 256;
    ESP_ERROR_CHECK(esp_console_init(&console_config));

    linenoiseSetMultiLine(1);

    linenoiseHistorySetMaxLen(100);
    linenoiseSetDumbMode(1);
}

std::string handle_line(const std::string& line)
{
    if (line.empty())
        return "";
    auto ch = line[0];
    auto rest = line.substr(1);
    bool ok = true;
    switch (ch)
    {
    case 'v':
    case 'V':
        return version();
        break;
    case 'c':
    case 'C':
        return get_card();
        break;
    case 's':
    case 'S':
        ok = play_sound(rest);
        break;
    case 'i':
    case 'I':
        ok = set_led_intensity(rest);
        break;
    case 'p':
    case 'P':
        ok = set_led_pattern(rest);
        break;
    default:
        return "ERROR: Unknown command: " + line + "\n";
    }
    if (ok)
        return "OK\n";
    return "ERROR\n";
}

extern "C" void console_task(void*)
{
    initialize_console();
    std::string line;
    while (1)
    {
        int ch = fgetc(stdin);
        if (ch != EOF)
        {
            if (ch == '\r' || ch == '\n')
            {
                const auto reply = handle_line(line);
                printf(reply.c_str());
                line.clear();
                continue;
            }
            line += ch;
            if (line.size() > 1024)
            {
                printf("ERROR: Line too long\n");
                line.clear();
            }
        }
    }
}
