bullestock/acsv2/frontend/esp32/main/defs.h

#pragma once

#include <string>
#include <vector>

#include <driver/gpio.h>
#include <driver/uart.h>

constexpr const char* IDENTIFIER_KEY = "id";
constexpr const char* DESCRIPTOR_KEY = "dsc";
constexpr const char* WIFI_KEY = "wifi";
constexpr const char* MQTT_ADDRESS_KEY = "mqa";
constexpr const char* ACS_TOKEN_KEY = "act";
constexpr const char* PRIVKEY_KEY = "pk";
constexpr const char* ISMAIN_KEY = "ism";

// 256 bits
constexpr const int SIGNING_KEY_SIZE = 32;

constexpr const auto RS485_UART_PORT = (uart_port_t) 2;
constexpr const int RS485_BAUD_RATE = 9600;

// Pin definitions
constexpr const int RS485_TXD = 16;
constexpr const int RS485_RXD = 15;
constexpr const int RS485_RTS = 13;
constexpr const auto PIN_DISP_DC = (gpio_num_t) 2;
constexpr const auto PIN_DISP_RESET = (gpio_num_t) 4;
constexpr const auto PIN_DISP_CS = (gpio_num_t) 5;
constexpr const auto PIN_DISP_SCK = (gpio_num_t) 18;
constexpr const auto PIN_DISP_SDO = (gpio_num_t) 19;
constexpr const auto PIN_DISP_SDI = (gpio_num_t) 23;
constexpr const auto PIN_EXT_1 = (gpio_num_t) 27;
constexpr const auto PIN_EXT_2 = (gpio_num_t) 26;
constexpr const auto PIN_RELAY = (gpio_num_t) 21;
constexpr const auto PIN_RED = (gpio_num_t) 34;
constexpr const auto PIN_GREEN = (gpio_num_t) 32;
constexpr const auto PIN_WHITE = (gpio_num_t) 35;
constexpr const auto PIN_LEAVE = (gpio_num_t) 33;
constexpr const auto PIN_DOOR = (gpio_num_t) 22;

#define CARD_ID_FORMAT "%010llX"

using wifi_creds_t = std::vector<std::pair<std::string, std::string>>;

// Local Variables:
// compile-command: "cd .. && idf.py build"
// End:
