bullestock/acsv2/frontend/esp32/main/nvs.h

#pragma once

#include "defs.h"

void init_nvs();

std::string get_mqtt_address();
std::string get_acs_token();
std::string get_identifier();
const uint8_t* get_private_key();
wifi_creds_t get_wifi_creds();
bool get_is_main();

void clear_wifi_credentials();
void add_wifi_credentials(const char* ssid, const char* password);
void set_mqtt_address(const char* address);
void set_acs_token(const char* token);
void set_identifier(const char* identifier);
void set_private_key(const uint8_t* key);
void set_is_main(bool is_main);

// Local Variables:
// compile-command: "cd .. && idf.py build"
// End:
