bullestock/acsv2/camcontrol/esp32/main/display.h

#pragma once

#include <string>
#include <vector>

#include "ssd1306.h"

class Display
{
public:
    Display(SSD1306_t& d);

    void clear();

    SSD1306_t* device();

    /// Add progress message (used during boot).
    void add_progress(const std::string& status);

    void set_status(bool cam_on, bool estop_on);

    void set_status(const std::string& main_status,
                    const std::string& aux_status);

private:
    SSD1306_t& display;
    // Used by add_progress()
    int row = 0;
    std::vector<std::string> lines;
};
