bullestock/acsv2/frontend/opi/cardreader.h

#pragma once

#include "serialib.h"

#include <atomic>
#include <mutex>
#include <string>
#include <thread>

class Card_reader
{
public:
    enum class Pattern {
        none,
        ready,
        enter,
        open,
        warn_closing,
        error,
        no_entry,
        wait,
    };

    enum class Sound {
        none,
        warning,
        warn_closing
    };
    
    Card_reader(serialib&);

    ~Card_reader();
    
    void set_pattern(Pattern);

    void set_sound(Sound);

    std::string get_and_clear_card_id();
    
private:
    static std::string detect_port();
    
    void thread_body();
    
    serialib& port;
    std::thread thread;
    bool stop = false;
    std::mutex mutex;
    std::string card_id;
    std::atomic<Sound> sound = Sound::none;
    std::atomic<Pattern> pattern = Pattern::none;
};
