bullestock/acsv2/frontend/opi/serial.h

#pragma once

#include "serialib.h"

struct Ports
{
    serialib display;
    serialib reader;

    bool complete() const;
};

Ports detect_ports();

int skip_prologue(serialib& serial, const std::string& port);
