bullestock/acsv2/(commit log)

2021-07-24 Complete simulation framework.
2021-07-25 Handle Leave button.
2021-08-21 Fix state after calibrating.
2021-08-21 Clear CALIBRATING message when calibration is complete.
2021-09-04 Consume reply when setting LEDs.
2021-09-05 Ensure that all swipes and button presses are sent to Slack.
2021-09-23 Copy from old project.
    [reader.kicad_pcb, reader.kicad_sch]
2021-09-24 Add RF125-PS.
    [reader.kicad_sch]
2021-09-24 Add level converter, regulator.
    [reader.kicad_sch]
2021-09-26 Add 4-pin USB connector.
    [reader.kicad_sch]
2021-10-09 Use LEDs more.
2021-10-24 Fix footprints.
    [reader.kicad_pcb, reader.kicad_sch]
2021-10-30 Finish routing.
    [reader.kicad_pcb, reader.kicad_sch]
2021-11-27 Fix footprint for 74LVC1T45.
    [reader.kicad_pcb, reader.kicad_sch]
2021-11-28 Fix switched RX/TX, adjust dimensions.
    [reader.kicad_pcb, reader.kicad_sch]
2021-11-28 Fix switched D-/D+.
    [reader.kicad_pcb, reader.kicad_sch]
2021-11-28 Fix silk screen.
    [reader.kicad_pcb]
2021-12-09 Update pin assignments for new PCB.
2021-12-20 Handle calibrate action.
2021-12-21 Ensure that door is closed and handle raised before performing manual calibration.
2021-12-21 Make manual calibration work.
2021-12-21 Go to initial state after manual calibration.
2021-12-22 Include calibration data in status.
2022-01-01 Fix UART pin number.
    [reader.cpp]
2022-01-01 Adjust LED patterns.
2022-01-01 Fix silkscreen issue; adapt buzzer footprint for 10 mm pin spacing.
    [reader.kicad_pcb]
2022-01-02 Fix 3D models.
    [reader.kicad_pcb, reader.kicad_sch]
2022-01-30 Move PCB up.
2022-01-30 Make top screw block smaller.
2022-02-02 Copy from reader.
    [display.kicad_sch]
2022-02-02 Start connecting display.
    [display.kicad_pcb, display.kicad_sch]
2022-02-04 Add more connections.
    [display.kicad_pcb, display.kicad_sch]
2022-02-04 Ready for routing.
    [display.kicad_pcb, display.kicad_sch]
2022-02-04 Do more routing.
    [display.kicad_pcb, display.kicad_sch]
2022-02-05 Add zones.
    [display.kicad_pcb]
2022-02-05 Fix 3D view.
    [display.kicad_pcb, display.kicad_sch]
2022-02-06 Adjust outline.
    [interface.kicad_pcb]
2022-02-10 Fix outline.
    [interface.kicad_pcb]
2022-02-18 Add power connector.
    [interface.kicad_pcb, interface.kicad_sch]
2022-02-26 Add boot switch.
    [display.kicad_pcb, display.kicad_sch]
2022-03-01 Fix line height for large text.
    [console.cpp]
2022-03-01 Fix max Y for small text.
    [console.cpp]
2022-03-06 Start work on barn hat.
    [hat.kicad_pcb, hat.kicad_sch]
2022-03-07 Fix port detection, add options.
    [display.cpp, display.h, main.cpp, serial.cpp, serial.h, util.h]
2022-04-10 Fix screwposts.
2022-04-10 Add plug hole.
2022-04-10 Add holes for fitting.
2022-04-11 Allow room for screws.
2022-04-11 Fix standoff placement.
2022-04-11 Fix standoffs Z-position.
2022-04-12 Make screws invisible.
2022-04-12 Fill zones.
    [hat.kicad_pcb, hat.kicad_sch]
2022-04-12 Enlarge screw holes.
2022-04-12 Adjust button hole size/position.
2022-04-12 Make screwposts square again.
2022-04-13 Add screwposts.
2022-04-13 Add button holes.
2022-04-14 Start thread.
2022-04-15 Increase thickness where buttons are.
2022-04-18 Make room for button connector.
2022-04-19 Add alternative cut method.
2022-04-19 Add mounting holes for USB plug shield.
2022-04-20 Add buttons.
    [display.kicad_pcb, display.kicad_sch]
2022-04-21 Use alternate method for cutting jack holes.
2022-05-04 Make insert holes a bit smaller.
2022-05-14 Fix pin mapping.
2022-05-18 Add LED control.
2022-05-18 Test LED.
2022-05-19 Fix button mapping.
2022-05-19 Implement manual relay control.
2022-05-19 Implement LED patterns.
2022-05-21 Implement missing functionality, fix bugs.
    [lock.cpp, lock.h]
2022-05-21 Fix a few minor issues.
    [buttons.cpp, controller.cpp, serial.cpp, util.cpp, util.h]
2022-05-26 Make relay state persistent.
2022-06-20 Return only users that have permission for the current machine.
2022-06-25 Refactor for better error handling.
    [buttons.cpp, cardreader.cpp, controller.cpp, controller.h, display.cpp, display.h, lock.cpp, logger.h]
2022-07-02 Log access to backend; add logging queue and thread.
2022-07-27 Add additional handle switch debouncing.
2022-07-28 Avoid extra newlines in lock debug output.
    [lock.cpp]
2022-07-31 Fix logging of entry.
    [cardcache.cpp, cardcache.h, cardreader.cpp, util.h]
2022-08-20 Add currentDevice().
2022-08-20 As a workaround, reopen card reader port evey hour.
    [cardreader.cpp, util.h]
2022-09-25 Fix bug in reopen logic.
    [cardreader.cpp]
2022-10-13 Fix logging of unknown cards.
    [cardcache.cpp, cardcache.h, controller.cpp, controller.h, logger.h, test.cpp, util.h]
2022-10-13 Exit if too many failures writing to lock.
    [lock.cpp, util.h]
2022-10-20 Include errno in error message.
    [lock.cpp, util.h]
2022-12-09 If card reader returns garbage, try to skip the ESP-IDF prologue.
    [cardcache.cpp, cardreader.cpp, serial.cpp, serial.h, util.h]
2022-12-17 Add input for door switch.
    [hat.kicad_pcb, hat.kicad_sch]
2023-01-05 Do not calibrate if door is open or handle is not raised.
2023-01-21 Read buttons less often.
2023-01-29 Enlarge button hole.
2023-02-03 Adjust edge cuts.
    [hat.kicad_pcb]
2023-02-18 Test door switch.
2023-02-18 Fix wrong port number.
    [main.py]
2023-02-18 Fix door closed test.
    [main.py]
2023-02-26 Handle missing RFID reader.
    [main.py]
2023-07-01 KiCad version bump.
2023-07-01 Control relay.
2023-07-06 Move Leave button to PA13.
2023-07-08 Revert "Add global libcurl mutex."
    This reverts commit e1c89dce10aff9511b63ede9760a474dae8b7cea.
    [cardcache.cpp, gateway.cpp, main.cpp, util.h]
2023-07-08 Retry reopen of serial port.
    [reader.kicad_pcb, reader.kicad_sch]
2023-07-08 USe RS-485 instead of USB.
    [reader.kicad_pcb, reader.kicad_sch]
2023-07-08 Change to WROOM32U.
    [reader.kicad_pcb, reader.kicad_sch]
2023-07-08 Complete routing.
    [reader.kicad_pcb]
2023-07-08 Start work on ESP32-based frontend.
    [main.kicad_pcb, main.kicad_sch, relay.kicad_pcb, relay.kicad_sch]
2023-07-08 Place mounting holes.
    [main.kicad_pcb]
2023-07-08 Finish relay board.
    [main.kicad_pcb, main.kicad_sch, relay.kicad_pcb, relay.kicad_sch]
2023-07-09 Add filter resistor.
    [relay.kicad_pcb, relay.kicad_sch]
2023-07-09 Increase capacitor value.
    [relay.kicad_pcb, relay.kicad_sch]
2023-07-09 Do first routing pass.
    [main.kicad_pcb]
2023-07-09 Final adjustments, order.
    [main.kicad_pcb, reader.kicad_pcb, relay.kicad_pcb]
2023-07-16 Use one button and three LEDs. Add 5V output.
2023-07-16 No idea.
    [hat.kicad_pcb]
2023-07-19 Adapter for small switch.
2023-07-19 Fix switch hole.
2023-07-21 Make LED flash.
2023-08-12 Remove capacitors.
    [reader.kicad_pcb, reader.kicad_sch]
2023-08-12 Fix buzzer pin definitions.
    [buzzer.cpp, console.cpp]
2023-08-12 Add skeleton for ESP32 frontend.
    [partitions.csv]
2023-08-18 Fix LED pin definitions.
    [led.cpp]
2023-08-18 Handle RS485 input in main thread.
2023-08-18 Revert to RDM6300 algorithm.
    [RDM6300.h, reader.cpp]
2023-08-24 Handle white button in timed_unlock state.
2023-09-16 Add NVS settings.
    [partitions.csv]
2023-09-20 Add missing slash, call to cleanup().
    [cardcache.cpp]
2023-09-23 Port Buttons.
2023-09-23 Configure button pins.
2023-09-23 Avoid that time moves around.
    [display.cpp, display.h]
2023-09-25 Add support for devkit boards.
2023-09-27 Clean up error logging
    [cardcache.cpp, gateway.cpp]
2023-10-01 Update for ESP32 solution.
2023-10-03 Add RTS pullup; move RS485 connector.
    [reader.kicad_pcb, reader.kicad_sch]
2023-10-07 Add R10.
    [main.kicad_pcb, main.kicad_sch]
2023-10-12 Swap red/white, set production mode.
    [defs.h, main.cpp]
2023-11-08 Integrate relay board components into main board. Add switches and LEDs.
    [main.kicad_pcb, main.kicad_sch]
2023-11-08 Add door switch.
    [main.kicad_sch]
2023-11-08 Add seconds display connector.
    [main.kicad_sch]
2023-11-08 Start placing additional components.
    [main.kicad_pcb, main.kicad_sch]
2023-11-08 Place remaining components.
    [main.kicad_pcb, main.kicad_sch]
2023-11-08 Add missing symbols and footprints.
2023-11-08 Fix last cosmetic issues.
    [main.kicad_pcb]
2023-11-18 Spacer for LED.
2023-11-20 Add smaller case.
2023-12-02 Start updating for new pcb.
2023-12-02 Remove orphan silk screen.
    [main.kicad_pcb]
2023-12-02 Add hole.
2023-12-03 If we have no wifi creds, do not start threads that need a net connection.
2023-12-03 Avoid unlocking on boot.
    [controller.h]
2023-12-08 Optimize routing.
    [reader.kicad_pcb]
2023-12-22 Make it possible to enter console if WiFi creds are wrong.
    [connect.cpp, connect.h, defs.h, main.cpp]
2023-12-26 Start adding support for uploading core dump after crash.
    [partitions.csv]
2024-01-07 Adjust display hole.
2024-01-11 Remove OPi version.
    [main.kicad_pcb, main.kicad_sch, relay.kicad_pcb, relay.kicad_sch]
2024-01-11 Use 'device' for consistency.
2024-01-13 Add ESP32 frontend KiCAD project in the correct place.
    [frontend.kicad_pcb, frontend.kicad_sch]
2024-01-13 Add reset/boot switches, minimize size.
    [reader.kicad_pcb, reader.kicad_sch]
2024-01-13 Make corners round.
    [reader.kicad_pcb]
2024-01-19 Reduce fill size.
    [frontend.kicad_pcb]
2024-01-20 Add device ident to all Slack messages.
2024-01-20 Include device in payload for /acsquery.
2024-01-27 Use Hal9k footprint library.
    [frontend.kicad_pcb, frontend.kicad_sch]
2024-01-28 Only check Leave button in locked state.
2024-02-06 Fix check for allow_open.
    [gateway.cpp]
2024-02-09 Enlarge holes.
2024-02-16 Make clear_wifi work correctly.
    [nvs.cpp]
2024-03-30 Add OTA partitions.
    [partitions.csv]
2024-04-01 Show resistor references on silk screen.
    [frontend.kicad_pcb]
2024-04-07 Remove track fragment
    [frontend.kicad_pcb]
2024-04-13 Show error LED pattern on loss of RS-485 communication.
    [buzzer.cpp, console.cpp, defines.h, led.cpp, reader.cpp]
2024-04-25 test_buttons: Show state of door switch.
2024-05-04 Fix card reader heartbeat.
    [controller.cpp, gateway.cpp]
2024-05-26 Add button labels.
2024-06-12 Fix reading of descriptor.
    [nvs.cpp]
2024-06-13 Use cert bundle. Add global HTTP mutex to avoid memory peaks.
    [cardcache.cpp, gateway.cpp, http.cpp, http.h, otafwu.cpp]
2024-06-13 Set 'space open' status correctly.
    [controller.cpp]
2024-07-25 Initial port to ESP32.
2024-08-15 Fix hole sizes.
2024-08-24 Update I2C pins.
2024-08-24 Fix bug in test_relay arg setup.
    [console.cpp]
2024-08-24 Update pin assignments, reduce code size.
2024-08-25 Move holes, fix power plug recess.
2024-08-26 Fix parsing of GW response.
    [console.cpp, gateway.cpp]
2024-08-27 Implement handling of both relays.
2024-08-31 Add support for remote reboot.
    [gateway.cpp]
2024-08-31 Show relay state on startup.
2024-08-31 Make clear() reset row.
    [display.cpp]
2024-09-05 Fix read of saved relay state.
    [main.cpp, nvs.cpp]
2024-09-28 Print version on boot.
2024-09-29 Improve debug.
    [reader.kicad_pcb, reader.kicad_sch]
2024-09-30 Fix uptime display. Enable debug log for HTTP client.
    [display.cpp, display.h, main.cpp]
2024-10-05 Add missing 'd' in uptime display.
    [display.cpp]
2024-10-17 Try to fix empty check.
    [controller.cpp]
2024-10-31 Fix open doors bug.
    [controller.cpp]
2025-08-27 Add scheduled reboot every night.
    [RDM6300.h, controller.cpp, logger.h]
2025-08-30 Make reboot time random.
    [controller.cpp]
2025-12-29 Add scheduled reboot.
    [partitions.csv]
2026-01-03 Fix arguments to esp_mqtt_client_enqueue().
    [mqtt.cpp]
2026-01-03 Remove coredump support, add MQTT logging.
    [partitions.csv]
2026-01-04 Use 3 AV connectors.
2026-01-15 Fix partitions, stack overflow etc.
    [main.cpp, otafwu.cpp]
2026-06-07 Clan up debug prints.
2026-07-11 Add get_private_key() and set_private_key() functions to NVS
    - Add private_key storage as uint8_t array with length tracking
    - Implement set_private_key() using nvs_set_blob() for binary data
    - Implement get_private_key() and get_private_key_len() accessors
    - Add private key initialization in init_nvs() using nvs_get_blob()
    - Use PRIVKEY_KEY as the NVS key
    [bottom.step]
2026-07-23 Try to fix status spam.
    [mqtt.cpp, mqtt.h]
2026-08-10 Enter console if red and green buttons are both pressed on boot.
2026-08-10 Compute reboot time based on identifier.
    [controller.cpp]
2026-09-09 Run updater in dedicated thread
